gadgetmies/nutrient-mixer/eagle/untitled.brd

## EAGLE design eagle/untitled.brd (2026-10-16)

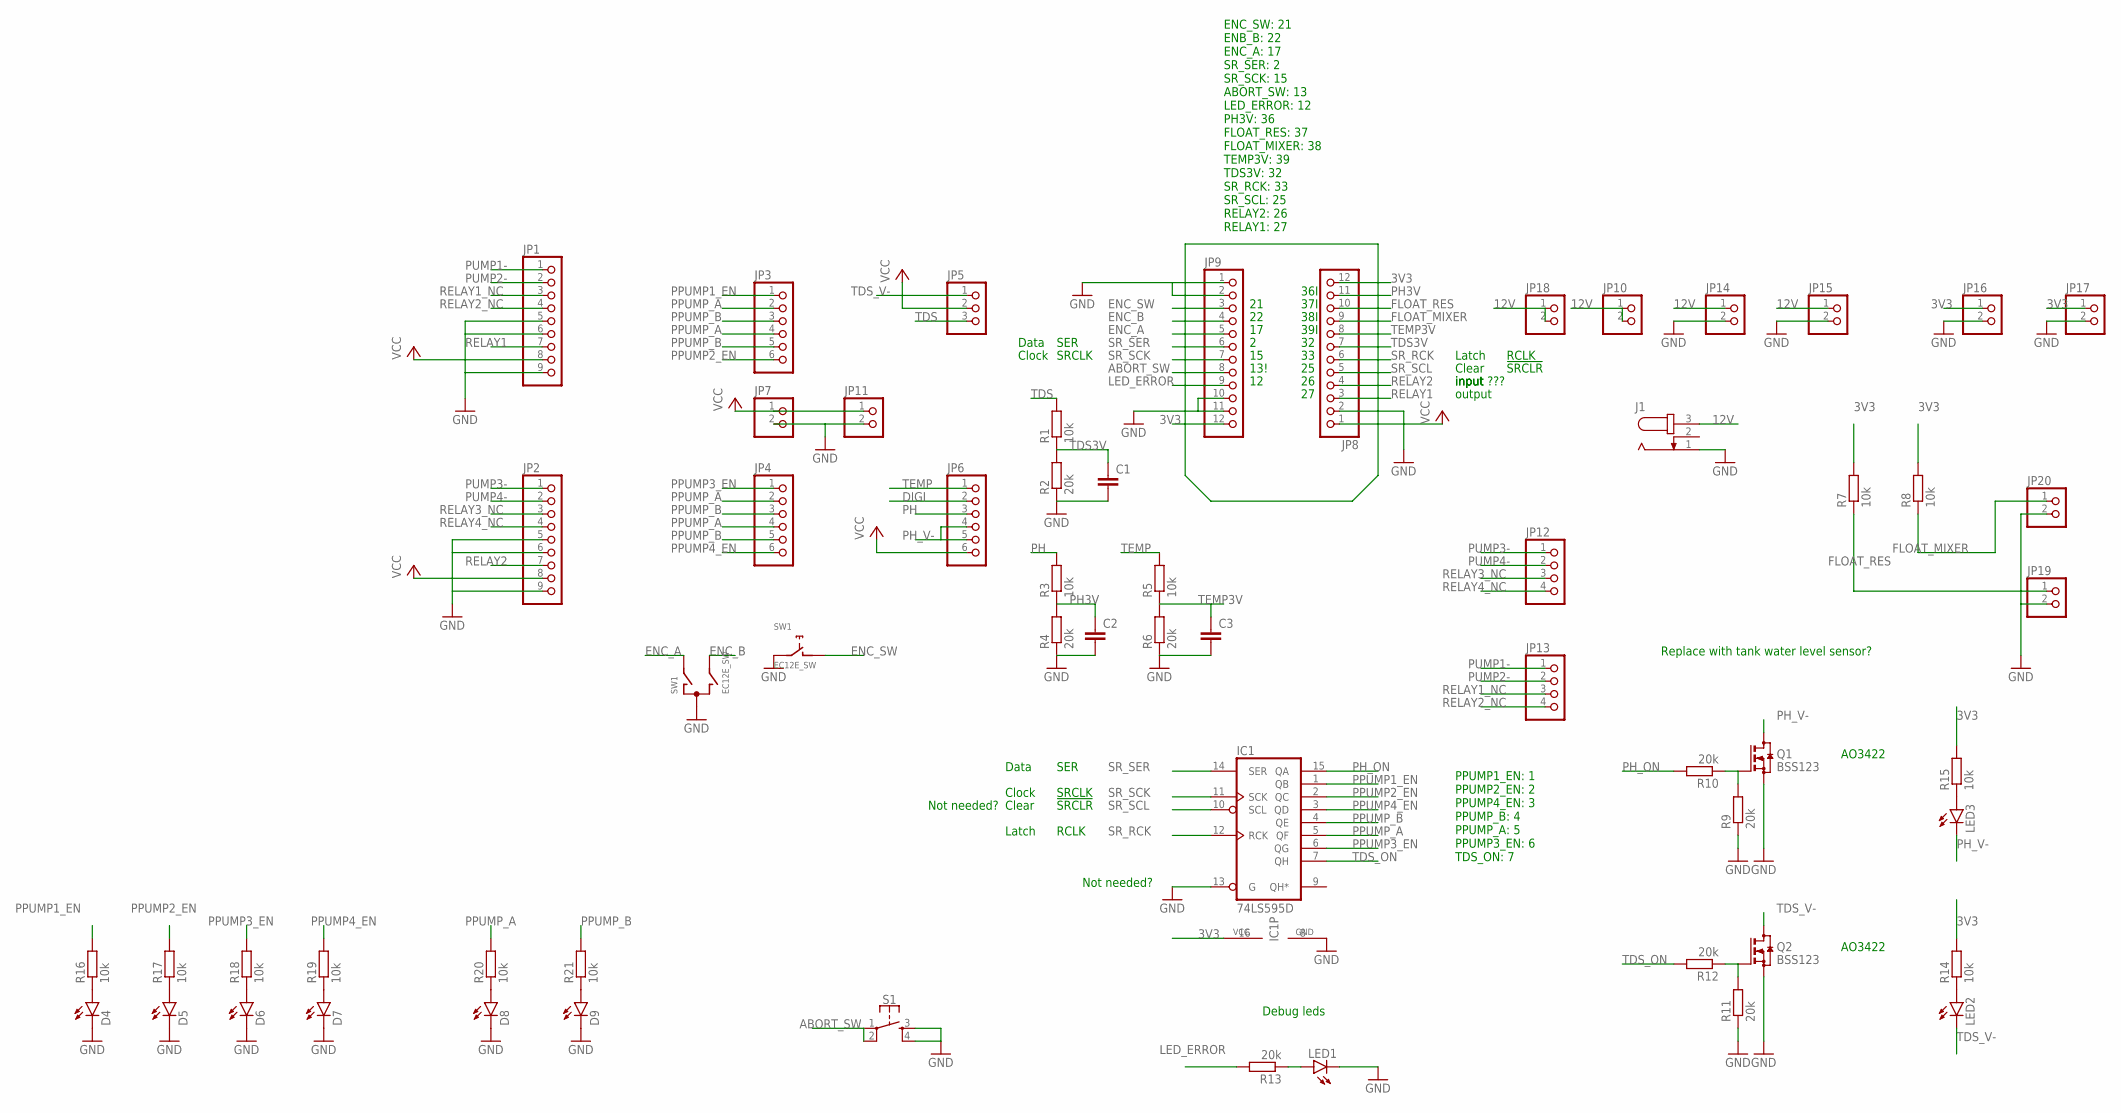
[picture p1: schematic untitled.sch]

Parts:
C1, C2, C3: C-EUC0805; C0805
D4, D5, D6, D7, D8, D9: LEDCHIP-LED0603; CHIP-LED0603
IC1: 74LS595D; SO16
J1: JACK-PLUG1; SPC4078
JP1, JP2: PINHD-1X9; 1X09
JP3, JP4, JP6: PINHD-1X6; 1X06
JP5: PINHD-1X3; 1X03
JP7, JP10, JP11, JP14, JP15, JP16, JP17, JP18, JP19, JP20: PINHD-1X2; 1X02
JP8, JP9: PINHD-1X12; 1X12
JP12, JP13: PINHD-1X4; 1X04
LED1, LED2, LED3: LEDCHIP-LED0603; CHIP-LED0603
Q1, Q2: BSS123; SOT23
R1, R3, R5, R7, R8, R14, R15, R16, R17, R18, R19, R20, R21: 10k; R0805
R2, R4, R6, R9, R10, R11, R12, R13: 20k; R0805
S1: MOMENTARY-SWITCH-SPST-2-SMD-5.2MM; TACTILE_SWITCH_SMD_5.2MM
SW1: EC12E_SW; ALPS_EC12E_SW

Connections:
3V3: IC1.16 (VCC), JP8.12, JP9.12, JP16.1, JP17.1, R7.2, R8.2, R14.2, R15.2
12V: J1.3, JP10.1, JP10.2, JP14.1, JP15.1, JP18.1, JP18.2
ABORT_SW: JP9.8, S1.1, S1.2
DIGI: JP6.2
ENC_A: JP9.5, SW1.A
ENC_B: JP9.4, SW1.B
ENC_SW: JP9.3, SW1.D (1)
FLOAT_MIXER: JP8.9, JP20.1, R8.1
FLOAT_RES: JP8.10, JP19.1, R7.1
GND: C1.2, C2.2, C3.2, D4.C, D5.C, D6.C, D7.C, D8.C, D9.C, IC1.8 (GND), IC1.13 (G), J1.1, JP1.5, JP1.6, JP1.9, JP2.5, JP2.6, JP2.9, JP7.2, JP8.2, JP9.1, JP9.2, JP9.10, JP9.11, JP11.2, JP14.2, JP15.2, JP16.2, JP17.2, JP19.2, JP20.2, LED1.C, Q1.2 (S), Q2.2 (S), R2.1, R4.1, R6.1, R9.1, R11.1, S1.3, S1.4, SW1.C, SW1.E (2)
LED_ERROR: JP9.9, R13.2
unnamed: LED2.A, R14.1
unnamed: LED1.A, R13.1
unnamed: LED3.A, R15.1
unnamed: D4.A, R16.1
unnamed: D5.A, R17.1
unnamed: D6.A, R18.1
unnamed: D7.A, R19.1
unnamed: D8.A, R20.1
unnamed: D9.A, R21.1
unnamed: Q1.1 (G), R9.2, R10.1
unnamed: Q2.1 (G), R11.2, R12.1
PH: JP6.3, R3.2
PH3V: C2.1, JP8.11, R3.1, R4.2
PH_ON: IC1.15 (QA), R10.2
PH_V-: JP6.4, JP6.5, LED3.C, Q1.3 (D)
PPUMP1_EN: IC1.1 (QB), JP3.1, R16.2
PPUMP2_EN: IC1.2 (QC), JP3.6, R17.2
PPUMP3_EN: IC1.6 (QG), JP4.1, R18.2
PPUMP4_EN: IC1.3 (QD), JP4.6, R19.2
PPUMP_A: IC1.5 (QF), JP3.2, JP3.4, JP4.2, JP4.4, R20.2
PPUMP_B: IC1.4 (QE), JP3.3, JP3.5, JP4.3, JP4.5, R21.2
PUMP1-: JP1.1, JP13.1
PUMP2-: JP1.2, JP13.2
PUMP3-: JP2.1, JP12.1
PUMP4-: JP2.2, JP12.2
RELAY1: JP1.7, JP8.3
RELAY1_NC: JP1.3, JP13.3
RELAY2: JP2.7, JP8.4
RELAY2_NC: JP1.4, JP13.4
RELAY3_NC: JP2.3, JP12.3
RELAY4_NC: JP2.4, JP12.4
SR_RCK: IC1.12 (RCK), JP8.6
SR_SCK: IC1.11 (SCK), JP9.7
SR_SCL: IC1.10 (SCL), JP8.5
SR_SER: IC1.14 (SER), JP9.6
TDS: JP5.3, R1.2
TDS3V: C1.1, JP8.7, R1.1, R2.2
TDS_ON: IC1.7 (QH), R12.2
TDS_V-: JP5.1, LED2.C, Q2.3 (D)
TEMP: JP6.1, R5.2
TEMP3V: C3.1, JP8.8, R5.1, R6.2
VCC: JP1.8, JP2.8, JP5.2, JP6.6, JP7.1, JP8.1, JP11.1

Notes on the sheet:
Replace with tank water level sensor?
39I
38I
37I
36I
13!
input
input ???
output
Not needed?
AO3422
Debug leds
ENC_SW: 21 ENB_B: 22 ENC_A: 17 SR_SER: 2 SR_SCK: 15 ABORT_SW: 13 LED_ERROR: 12 PH3V: 36 FLOAT_RES: 37 FLOAT_MIXER: 38 TEMP3V: 39 TDS3V: 32 SR_RCK: 33 SR_SCL: 25 RELAY2: 26 RELAY1: 27
PPUMP1_EN: 1 PPUMP2_EN: 2 PPUMP4_EN: 3 PPUMP_B: 4 PPUMP_A: 5 PPUMP3_EN: 6 TDS_ON: 7
SER
SRCLK
!SRCLR
RCLK
Data
Clock
Clear
Latch

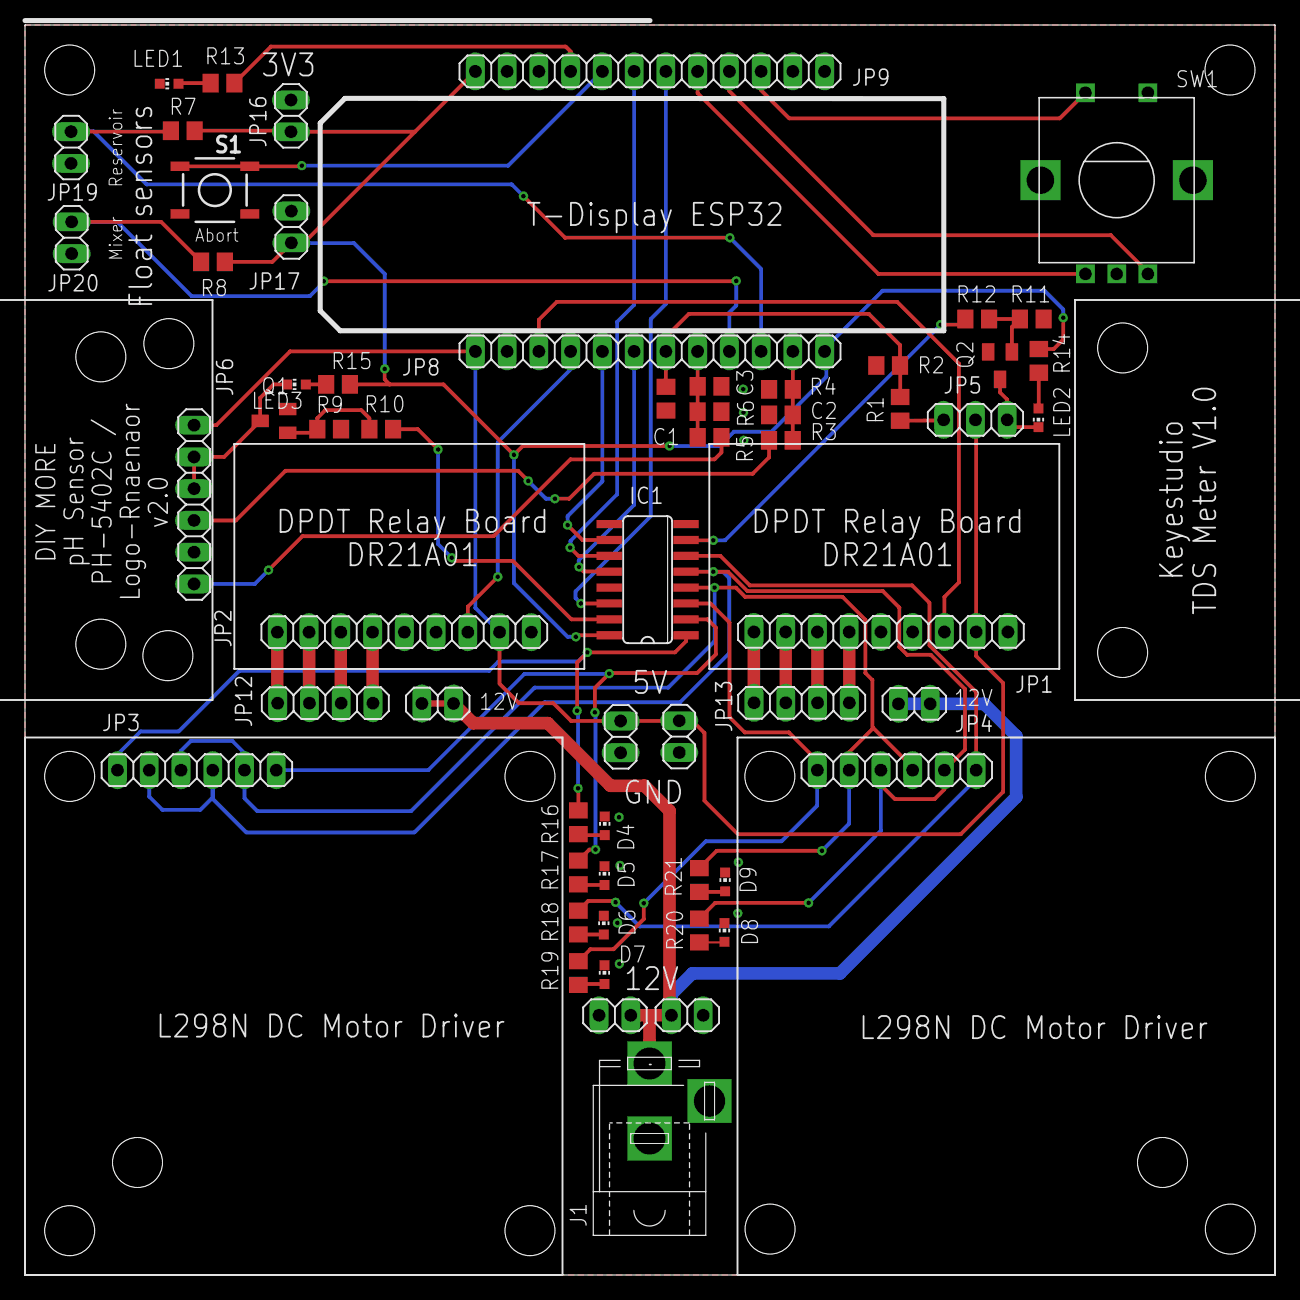
[picture p2: board untitled.brd from above]

Board: 2 copper layers, 100.0 x 100.0 mm, 59 parts (0 on the bottom side), 52 nets.
